rudnik275/kindle-calendar/dashboard/art/source-ref.png

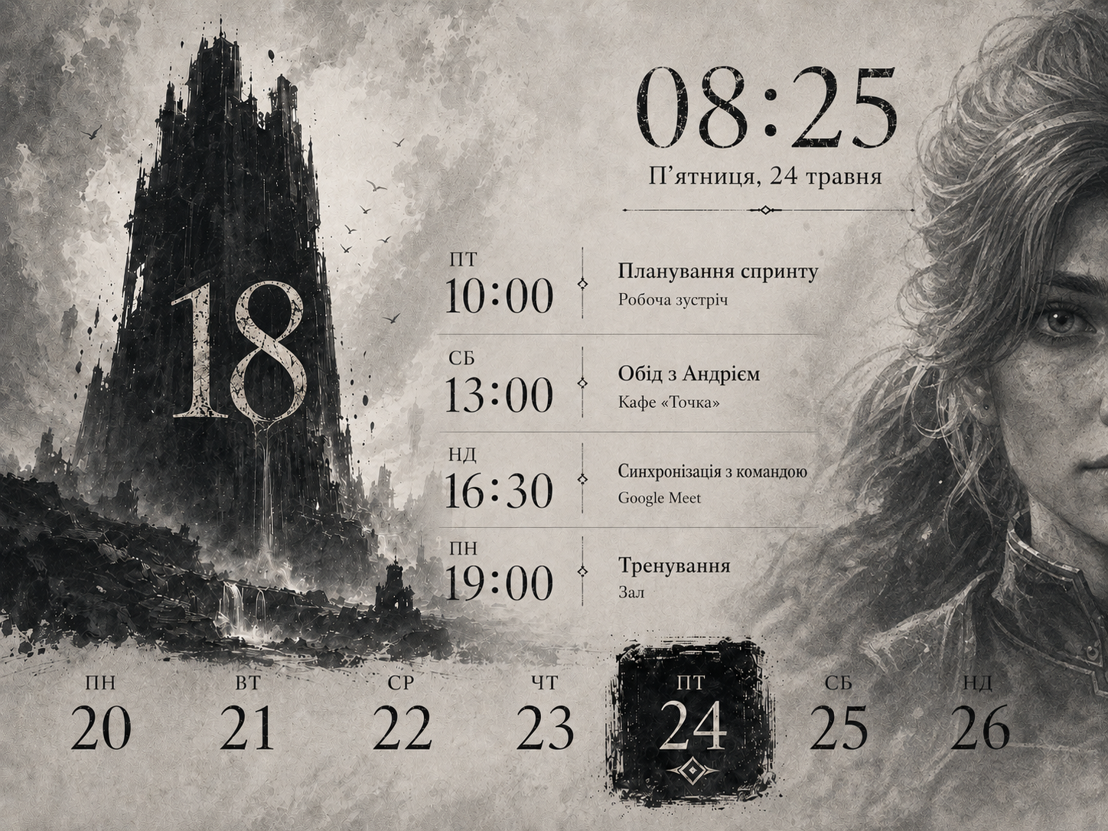
dashboard/art/source-ref.png
