rudnik275/kindle-calendar/dashboard/art/bg.png

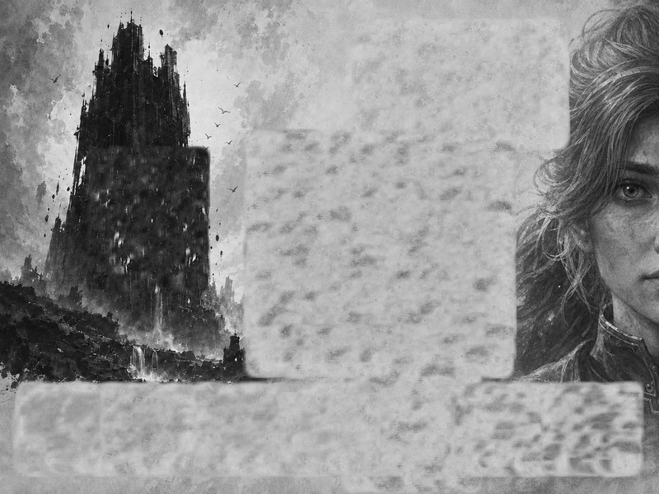
dashboard/art/bg.png
