rudnik275/kindle-calendar/dashboard/README.md

# Дашборд Kindle-календаря — dark fantasy v2 (2026-08-27)

Дизайн v2 на ассетах користувача: фон «вежа + портрет» (`art/bg2.png`),
гранжева плашка активної дати (`art/today-plate.png`), текстура зносу
шрифтів (`art/ink-mask.png`, альфа-маска — клас `.worn`, ТІЛЬКИ на великих
цифрах: дрібний текст із дірками e-ink розриває). Шрифти: Cormorant Garamond
(цифри/дисплей) + Forum (капс-лейбли) + PT Serif (текст), повна укр.
кирилиця, **локально** в `art/fonts/` — рендер не залежить від інтернету.
Екран 800×600 landscape → на панель іде портрет 600×800 (ROTATE=270 —
надрукований корпус тримає книгу «догори ногами» відносно голого
пристрою, під який калібрували до корпусу; без корпусу це було 90).

Живі дані: температура на вежі + маленька цифра «відчувається як» під нею
(Open-Meteo, координати в `live-push.sh`), годинник, дата, курс долара в
обмінниках Києва в орнамент-лінії під датою (`$ купівля · продаж`; без
даних лінія повертається до ромба), події з `local-data.js`, тижнева
стрічка з плашкою на сьогодні.

Події — 4 слоти по 72px між датою і стрічкою тижня. Рядок росте, коли
назва переноситься на 3 рядки або є локація, і 4 таких рядки лягали на
стрічку тижня (фото 2026-09-04). `fit()` у шаблоні підбирає вміст: спершу
максимум подій, потім мінімум ущільнення — повні назви → назви до 2 рядків
(хвіст «…») → без локацій → на одну подію менше. Блок ще й обрізаний по
висоті (`overflow:hidden`) як страховка. Відтворити будь-який кейс: покласти
події в `local-data.js` і `./render.sh`.

## Архітектура: живе оновлення (з 2026-08-27)

**NAS — рендерер і пушер** (`live-push.sh` у Docker-контейнері `kindle-dash`,
ставиться `nas/install-nas.sh`, деталі — `nas/README.md`). Мак робить те саме
й тим самим скриптом, але тільки як резервний шлях (`install-live.sh`,
launchd-демон `com.rudnik.kindle-dash`) — **разом їх вмикати не можна**,
битимуться за екран.

Цикл конвеєра (однаковий на обох):

- щохвилини (вирівняно на початок хвилини): рендер → push у
  `/tmp/dash-live.png` книги (tmpfs = RAM, NAND не зношується) →
  `eips -g` (частковий refresh, без блимання);
- кожні 30 хв — повний refresh (`eips -f -g`) проти ghosting;
- щогодини — копія кадру в `/mnt/us/dashboard/local/screen.png` (NAND):
  єдине, що переживає ребут книги;
- кожні 15 хв — погода Open-Meteo → `local-weather.js` (атомарно; без
  інтернету лишається останнє значення);
- 2 рази на добу — курс долара → `local-rates.js` (той самий контракт
  живучості). Основне джерело — JSON-LD зі сторінки minfin «курс у
  Києві» («середній готівковий» = середнє по обмінниках; schema.org-
  розмітка для пошуковиків, стабільніша за HTML-верстку), фолбек — API
  monobank (без ключа, курс близький до готівкового). Обидва впали →
  ретрай за 30 хв, на екрані лишається останній курс;
- кожні 15 хв — події з приватних iCal-фідів Google Calendar
  (`ical-sync.py` → `local-data.js`, теж атомарно; фіди не відповіли —
  лишаються попередні події). Тільки на NAS: на маку файлу з URL немає,
  і синк тихо пропускається;
- раз на добу — синк годинника книги (`date -u -s` + `hwclock -w`,
  RTC книги дрейфує роками);
- працює **24/7** — нічного режиму немає (рішення 2026-08-27), годинник
  тікає завжди;
- **watchdog**: 5 збоїв рендера поспіль або година без книги → вихід із
  кодом 1, щоб супервізор (`restart: always` / launchd `KeepAlive`) підняв
  процес із чистим Chrome. Це лікує клас «завис Chrome», який зсередини
  не розгребти.

### Ступор ≠ падіння (урок 2026-08-30)

Лічильники збоїв ловлять тільки те, що **впало**. Мовчазний ступор вони не
бачать: цикл стоїть на команді, яка не повертається, лічильник не росте, і
екран книги лишається з давнім кадром. Так дашборд простояв 1.5 години на
16:32 — при живому контейнері й здоровому Docker.

Причина була не в книзі й не в коді: планові скани медіатек (Plex — **кожні
~64 хв**, Jellyfin — свій) на NAS із 1.7 ГБ RAM видавлювали Chrome у своп.
Він починав вичитувати власні сторінки назад із диска, забитого тими ж
сканами: 40+ МБ/с підкачки, `load average` 18 при **простоюючому CPU**, черга
до диска ~100 операцій. Рендер ріс із секунд до 4-6.5 хвилин, а такт циклу —
одна хвилина.

Три запобіжники, кожен на своєму рівні:

- `render.sh` — `RENDER_TIMEOUT` (90 с) навколо Chrome: ступор стає звичайним
  збоєм, який лічильники вже вміють лікувати. Убитий Chrome лишає дітей —
  вони відстрілюються по власному `user-data-dir`;
- `live-push.sh` — сторож за `state/heartbeat` (`HEARTBEAT_STALL`, 7 хв):
  ловить зависання будь-де (ssh, curl, python), знімає зависле піддерево й
  шле `USR1`. Вбити PID 1 зсередини контейнера сигналом **не можна** — ядро
  не доставляє SIGKILL ініту namespace'у без обробника, звідси така схема;
- `docker-compose.yml` — `mem_swappiness: 0`: сторінки рендера не потрапляють
  у своп узагалі.

**Як розпізнати за 30 секунд:** `uptime` на NAS — високий `load average` при
`CPU` біля нуля в дужках означає, що всі стоять у черзі до диска, а не
рахують. Далі `docker ps --filter name=kindle-dash` → `unhealthy` = heartbeat
протух. Книга при цьому справна: вона штатно показує останній кадр.

⚠️ `sudo docker` на NAS відповідає `command not found` — це `secure_path`, а не
зламаний Docker. Повний шлях: `/usr/local/bin/docker`.

Рантайм навмисно **поза git** — на NAS це `/volume1/docker/kindle-dash/app`,
на маку деплой-копія `~/kindle-dash-live/`: перемикання гілок, мерджі й
чистки worktree не чіпають працюючий демон. Після зміни шаблону чи скриптів
— перезапустити відповідний інсталятор.

**Книга — тупий e-ink дисплей із фолбеком** (kindle-dash, `dash.sh`):

- цикл `*/15 * * * *` цілодобово: `fetch-dashboard.sh` бере
  `/tmp/dash-live.png`, якщо він свіжіший за NAND-копію, інакше
  `local/screen.png` — конвеєр упав/мережа зникла → екран живе далі з
  останнім кадром;
- `FULL_DISPLAY_REFRESH_RATE=96` — свій повний refresh лише раз на добу
  (основні робить мак);
- `sleeping.png` = нічний арт (сток «Kindle is sleeping» у
  `sleeping.png.bak-stock`); при 24/7-розкладі книга сама його не малює —
  чистий фолбек;
- супервізор `/var/local/sshd/start-ssh.sh` (cron `*/5`): sshd + dash по
  PID-файлах + **мережевий watchdog** — 3 страйки (~15 хв) без пінгу
  шлюзу → рестарт радіо (`wirelessEnable 0/1`), 24 страйки (~2 год) →
  ребут (все відроджується з cron; наступний ребут не раніше ніж за 6 год
  — без ребут-шторму при мертвому роутері);
- DEBUG=true (без suspend) — книга на постійному живленні, не спить;
- профілактичний тижневий ребут (cron: пн 01:45 UTC ≈ 04:45 Києва) —
  проти повільних витоків прошивки 2011 року; екран повертається сам
  за ~2 хв.

## Файли

- `template.html` — єдине джерело правди дизайну; JS на момент рендера:
  годинник, дата, події (`local-data.js`, gitignored, контракт у шапці),
  погода (`local-weather.js`, пише live-push), курс долара
  (`local-rates.js`, теж пише live-push), тиждень. Плашка сьогодні —
  `art/today-plate.png`. Великі цифри Cormorant — старостильні, з нижніми
  виносами: блоки з маскою `.worn` мусять мати padding-bottom, інакше
  маска кліпає по border-box і зрізає хвости (фікс 2026-08-27).
- `night.html` — джерело sleeping.png-фолбека (чистий арт + орнамент);
  у живому циклі НЕ використовується (нічного режиму немає).
- `render.sh` — headless Chrome/Chromium (**--allow-file-access-from-files**
  — інакше CSS-маска з file:// не рендериться) → ROTATE → grayscale.
  Кросплатформний: на маку Google Chrome + `sips`, на Linux/NAS
  `chromium` + ImageMagick (`-grayscale Rec709Luma` — голий
  `-colorspace Gray` рахує по лінійному світлу й висвітлює півтони).
- `live-push.sh` — живий конвеєр (вище), один на обидві платформи.
- `ical-sync.py` — приватні iCal-фіди → `local-data.js`. URL-и лежать у
  `secret/ical-urls` (0600, поза git) і **ніколи не друкуються в лог**.
- `nas/` — Docker-обвʼязка для Synology: `install-nas.sh`, `Dockerfile`,
  `docker-compose.yml`, `entrypoint.sh`, `healthcheck.sh` + `nas/README.md`.
- `install-live.sh` — резервний launchd-шлях на маку.
- `push-to-kindle.sh` — разова ручна заливка (діагностика).
- `calibration.html` — калібрувальна карточка e-ink.

## Ручні операції

```
ROTATE=0 ./render.sh out/preview.png        # подивитись макет (landscape)
./render.sh && ./push-to-kindle.sh          # разова заливка вручну

nas/install-nas.sh                          # ШТАТНО: перевстановити на NAS
ssh nas "sudo -n docker exec kindle-dash tail -f /app/live-push.log"

./install-live.sh                           # РЕЗЕРВ: підняти конвеєр на маку
launchctl bootout gui/$(id -u)/com.rudnik.kindle-dash   # зупинити мак-демона
```

⚠️ Одночасно на NAS і на маку конвеєр не вмикати — два пушери битимуться
за екран, e-ink блиматиме.
