rudnik275/kindle-calendar/KindleDeskCalendar/README_RU.md

# Асимметричный корпус-календарь для Kindle 4 — v0.2

Настольный e-ink календарь: Kindle 4 (D01100) горизонтально, виден только экран,
загрузка сзади, сверху козырёк с тёплой подсветкой. Референс — сгенерированный
рендер «скульптуры» (см. чат от 2026-08-24/25).

## Файлы

- `KindleDeskCalendar.py` — генератор модели Fusion 360 (v0.2). Единственный
  источник правды — блок `CONFIG` в начале. Правишь CONFIG → перезапускаешь.
- `KindleDeskCalendar_v0.1.py.bak` — исходная версия от ChatGPT (архив).
- `KindleDeskCalendar.manifest` — манифест для Scripts and Add-Ins.
- `stl/` — **только v0.1, болванки для оценки масштаба. Не печатать.**
- `profiles/front_profiles.dxf` — контуры фасада v0.1.

## Что изменилось в v0.2 (после ревью)

1. **USB-бухта сбоку, не снизу.** В ландшафте разъёмная грань Kindle 4
   вертикальна. Добавлен карман под угловой micro-USB штекер + канал кабеля
   вниз + вырез в задней крышке. Сторона (`usb_side`) и позиция
   (`usb_center_y`) — уточнить по реальному девайсу.
2. **Прижим по глубине.** 4 бобышки на задней крышке добирают зазор 2.85 мм —
   Kindle больше не болтается.
3. **Крепёж.** 4 винта M2.5: сквозные отверстия d2.8 в крышке + пилоты d2.2 в
   корпусе. Козырёк — 2 штифта d4 в отверстия d4.4 на фасаде (+ клей).
4. **Устойчивость.** Отдельная базовая плита 210×80×8 с двумя рельсами
   (паз 15.4 мм). Низ силуэта сплющен (130 мм по y=−72) и садится в паз.
   Плита моделируется лёжа (ориентация печати), в сборке не спозиционирована.
5. **Ровные прямоугольники.** Все прямоугольные контуры — линии + дуги
   (в v0.1 были fitted-сплайны: волнистые кромки, недокрученные углы).
6. **Убраны фиктивные userParameters** — они не двигали геометрию и вводили
   в заблуждение.

## Перед печатью — измерить штангенциркулем

`kindle_width/height/depth`, `screen_width/height`, `screen_center_x/y`,
`screen_corner_radius`, `usb_side`, `usb_center_y`. Первая печать — плоская
маска окна 0.8–1 мм и купон посадки кармана, только потом корпус.

## Печать (PETG, Bambu A1 у друга)

- Фасад: лицом вниз на текстурной пластине, 0.16–0.20 мм, 4 периметра.
- Крышка, плита: как лежат в модели. Плита уже смоделирована печатной стороной.
- Диффузор: молочный/натуральный PETG, 1–2 периметра, 100% прозрачного эффекта
  не ждать — это и есть рассеивание.
- Козырёк: отдельно, штифтами вниз обычно не выйдет — печатать плоскостью
  примыкания вниз, штифты вверх (или отверстия под отдельные штифты-палочки).

## Подсветка и питание (решение от 2026-08-25, ревизия: без Aqara T1)

- Свет: **ESP32 + HAA** (стек лампы-космонавта) + MOSFET logic-level
  (AO3400/IRLZ44N, затвор 100R + pulldown 10k) + **COB-лента 5V** тёплая
  2700–3000K, отрезок ~30 см в козырьке за диффузором, 30–40° вниз,
  яркость 20–30%. Нативный HomeKit white dimmer, ~350–650 грн итого.
- **Кнопка на GPIO** (тактовая или TTP223) — HAA поддерживает из коробки:
  и физическая клавиша, и Home.app/Siri. Автоматизации по расписанию —
  после покупки Apple TV (нужен домашний хаб Apple).
- Питание: **одно гнездо USB-C наружу** (breakout ОБЯЗАТЕЛЬНО с CC-резисторами
  5.1k — иначе кабель C→C не заведётся), любая зарядка 5V/2A. Внутри общая
  5V-шина: micro-USB хвост в Kindle (**D+ и D− закоротить** — сигнал DCP),
  ESP32 на VIN, лента через MOSFET. Бюджет тока: ≤0.5A Kindle + ~0.3A лента
  + ~0.2A ESP32 < 1.5A. LED к плате/батарее Kindle НЕ подключать.
- v0.3 корпуса: гнездо USB-C и отсек электроники — в базовой плите (карман
  ~60×40×6 с крышкой снизу), кнопка — верхний торец или декор-отверстие.
- Софт: NAS рендерит PNG 600×800 (MagicMirror² → headless Chrome), Kindle с
  jailbreak + kindle-dash тянет картинку по Wi-Fi.

## Известные ограничения v0.2

- Плита не спозиционирована в сборке (моделируется лёжа для печати).
- Козырёк держится на 2 штифтах + клей; при желании добавить винт M2.5 сверху.
- Форма — 2.5D экструзия силуэта, не полная «скульптура» из референса;
  скругления/лофт фасада — кандидат на v0.3 после первой примерки.
