rudnik275/kindle-calendar/dashboard/nas/README.md

# Рендер-конвеєр на NAS (Synology DSM 7)

Штатне місце життя конвеєра. Мак більше не точка відмови: він може спати,
перезавантажуватись і їхати у відпустку — годинник на книзі тікає далі.

```
Google Calendar (приватні iCal) ─┐
Open-Meteo (погода) ─────────────┤
                                 ▼
   NAS · Docker «kindle-dash» · щохвилини
   ical-sync.py → local-data.js ┐
   curl → local-weather.js      ├→ chromium 800×600 → ImageMagick → PNG 600×800
                                ┘                              │
                                                               ▼
                              ssh root@kindle: cat > /tmp/dash-live.png; eips -g
```

## Розгортання й оновлення

З мака, з каталогу репозиторію:

```
dashboard/nas/install-nas.sh              # деплой + збірка образу + старт
dashboard/nas/install-nas.sh --no-build   # тільки оновити бандл і рестарт
```

Скрипт ідемпотентний — ганяй після кожної правки `template.html`, `render.sh`
чи `live-push.sh`. Він не чіпає рантайм-стан: `app/state`, `app/secret`,
`app/ssh`, `app/local-data.js`, `app/local-weather.js`.

Образ збирається **на самому NAS**: мак — arm64, NAS — x86_64.

## Розкладка на NAS

```
/volume1/docker/kindle-dash/
├── docker-compose.yml   Dockerfile   entrypoint.sh   healthcheck.sh
└── app/                     ← бінд-маунт у контейнер як /app
    ├── template.html night.html render.sh live-push.sh ical-sync.py art/
    ├── local-data.js        ← генерує ical-sync.py (у git не йде)
    ├── local-weather.js     ← генерує live-push.sh (у git не йде)
    ├── live-push.log
    ├── ssh/                 ← ключ NAS→книга (0600) + known_hosts
    ├── secret/ical-urls     ← приватні iCal-URL, 0600 (у git не йде)
    └── state/               ← мітки часу, heartbeat, лок
```

Увесь стан — на `/volume1`, тому перестворення контейнера чи ребут NAS
нічого не втрачають.

## Календар: увімкнути живі події

Поки файлу `secret/ical-urls` немає, на екрані висить снапшот подій, залитий
при першому деплої. Щоб події оновлювались самі, треба покласти приватні
iCal-URL Google Calendar.

Де взяти: Google Calendar → налаштування потрібного календаря → «Інтеграція
календаря» → **Приватна адреса в форматі iCal**.

> ⚠️ Такий URL = пароль на читання календаря. Канонічне місце зберігання —
> 1Password; на NAS він лежить у файлі 0600 і ніде більше. У логи він не
> потрапляє: `ical-sync.py` друкує лише порядковий номер фіда, не адресу.
> Не вставляй ці URL у чат і не коміть у репозиторій — він публічний.

**Як додати (по разу на кожен календар):** натисни в Google Calendar око 👁
біля «Закритої адреси», потім кнопку копіювання — і одразу:

```
dashboard/nas/add-ical-url.sh          # бере URL із буфера обміну
dashboard/nas/add-ical-url.sh --ask    # або прихований ввід, якщо буфер не годиться
```

Скрипт перевіряє формат, кладе URL у файл 0600 на NAS, відсіює дублікати
(порівняння робиться на боці NAS) і одразу ганяє синк, показуючи лише
**кількість** подій. Саме значення не друкується ніде.

ℹ️ Емодзі з назв подій (`🎂 День народження`) `ical-sync.py` вирізає: локальні
шрифти їх не мають, і на екрані замість емодзі був порожній квадрат-tofu перед
текстом. Тягнути емодзі-шрифт заради монохромного e-ink сенсу немає — вони б
однаково виглядали чужорідно. Тире, градуси й решту типографіки не чіпаємо.

⚠️ **Розкрити «Закриту адресу» може тільки людина.** Google тримає поле
замаскованим (`••••••••••`) і не піддається ні JS-кліку, ні довіреному
CDP-кліку, ні натисканню кнопки копіювання з автоматизації — перевірено.
Це навмисний захист Google, обходити його не треба: два кліки руками і
`add-ical-url.sh` роблять усе решта.

### ⛔ Робочий календар Novaposhta — РІШЕННЯ: НЕ РОБИМО (Дмитро, 2026-08-27)

**Питання закрите, розкопувати заново не треба.** Дашборд показує лише
особистий календар; те, що Дмитро сам додає до нього, зʼявляється на екрані
автоматично. Просити IT про схвалення він не буде, обхідні шляхи —
відхилено. Нижче — чому, щоб не проходити цей шлях удруге.

Окремо перевірено й відкинуто ідею «просто затягнути робочі події в основний
календар»: єдиний автоматичний спосіб — скрипт під робочим акаунтом, тобто
той самий обхід. Дозволений шаринг «вільний/зайнятий» теж не рятує — робочий
календар зайшов би в особистий акаунт **окремим** календарем, а приватна
iCal-адреса видається на кожен календар окремо й належить власнику, тож на
дашборд ці блоки все одно не потрапляють.

#### Що саме заблоковано (три незалежні контролі)

Перевірено 2026-08-27 у живому акаунті:

- у розділі «Інтеграція календаря» пункту **«Закрита адреса у форматі iCal»
  немає взагалі** — після загальнодоступної адреси одразу «Видалити календар»;
- у діалозі «Доступ для окремих користувачів» зовнішній адресі
  (`dmitriyrudnik@gmail.com`) варіант **«переглядати всі деталі подій»
  вимкнений** (`disabled`), доступний лише «вільний/зайнятий».

Тобто адмін Workspace novaposhta.ua заборонив віддавати календар **назовні**:
ні анонімному iCal-URL, ні іншій пошті деталі подій не дістаються.

⚠️ **Але це стосується лише зовнішнього доступу — не доступу самого власника.**
Коли Дмитро дивиться календар на планшеті, він залогінений як
`rudnyk.dm@novadigital.com` і бачить усе: ACL тут ні до чого, він власник.
Дашборд не бачить подій не тому, що заборонено, а тому, що він **ні під ким
не залогінений** — тягне анонімний URL.

Отже робочий шлях: конвеєр має ходити в Google **як робочий акаунт**, тобто
бути звичайним календарним клієнтом (як застосунок на планшеті):

- **Google Calendar API з OAuth під робочим акаунтом** — ⛔ теж заблоковано.
  Проєкт `kindle-dash-506809` створено, Calendar API увімкнено, OAuth-клієнт
  (Desktop) готовий, `gcal-authorize.py` написано — але на кроці згоди Google
  віддає **`access_not_configured`**: «You can't access this app until an admin
  at your institution reviews and configures access for it». У НП увімкнено
  **App Access Control**: сторонні OAuth-застосунки має схвалити адмін.
  Запит на схвалення (посилання дав сам Google):
  `https://admin.google.com/ac/owl/requestapp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`
  Після схвалення все готове: `gcal-authorize.py` → токен → NAS.
- **Google Apps Script** — доступний (перевірено: не заблокований, тригери є),
  бо виконується як код самого користувача в межах домену.

⚠️ **Але варто бачити картину цілком.** НП закрила цей напрямок **тричі
незалежно**: немає приватної iCal-адреси, зовнішній шаринг обрізано до
«вільний/зайнятий», сторонні OAuth-застосунки — тільки з дозволу адміна.
Це не випадковість, а свідома позиція: календарні дані не мають залишати
кероване середовище. Apps Script технічно винесе ті самі дані повз ці
контролі — рішення про це має ухвалювати Дмитро як співробітник, який знає
внутрішні правила, а не автоматика.

Чистий шлях — попросити IT НП: або схвалити застосунок за посиланням вище,
або увімкнути зовнішній доступ (Admin console → Apps → Google Workspace →
Calendar → Sharing settings) — тоді «Закрита адреса» зʼявиться сама й
`add-ical-url.sh` усе доробить.

## Живучість при перезавантаженні NAS

П'ять незалежних шарів — жоден не вимагає ручних дій після ребуту:

| Шар | Що дає |
|---|---|
| `restart: always` | демон Docker піднімає контейнер, щойно стартує сам |
| Container Manager стартує з DSM | демон Docker узагалі зʼявляється після ребуту |
| стан на `/volume1` (бінд-маунт) | події, погода, лог, мітки часу переживають усе |
| все зашите в образ | на старті не потрібні ні інтернет, ні реєстр: NAS вантажиться швидше за роутер |
| watchdog у `live-push.sh` | серія збоїв рендера (5) або година без книги → `exit 1` → Docker піднімає з чистим Chrome |

Плюс `healthcheck.sh`: у `docker ps` видно `healthy`/`unhealthy` за свіжістю
`state/heartbeat` (поріг 5 хв). Це індикатор, лікування робить watchdog.

Книга з іншого боку теж самостійна: cron-супервізор, мережевий watchdog,
щотижневий профілактичний ребут, фолбек на NAND-копію кадру. Якщо конвеєр
мовчить, екран не гасне — просто завмирає на останньому кадрі.

### Перевірка після змін

```
ssh nas "sudo -n docker kill kindle-dash"     # має піднятися сам за секунди
ssh nas "sudo -n docker ps --filter name=kindle-dash"
```

## Щоденне

```
# лог конвеєра
ssh nas "sudo -n docker exec kindle-dash tail -f /app/live-push.log"

# стан і здоровʼя
ssh nas "sudo -n docker ps --filter name=kindle-dash --format '{{.Status}}'"

# памʼять (NAS має 10 ГБ від 2026-09-03; лімітів у контейнера немає)
ssh nas "sudo -n docker stats --no-stream kindle-dash"

# разовий рендер без пуша (подивитись, що вийшло)
ssh nas "sudo -n docker exec kindle-dash bash -c 'QUIET= /app/render.sh /tmp/t.png'"
```

## Мак як резервний шлях

Старий launchd-конвеєр нікуди не подівся — `dashboard/install-live.sh`.
Обидва одночасно вмикати НЕ можна: вони битимуться за екран, e-ink
блиматиме. Перемикання:

```
launchctl bootout gui/$(id -u)/com.rudnik.kindle-dash        # вимкнути мак
ssh nas "cd /volume1/docker/kindle-dash && sudo -n docker compose stop"   # вимкнути NAS
```
