rudnik275/kindle-calendar/dashboard/art/bg2.png

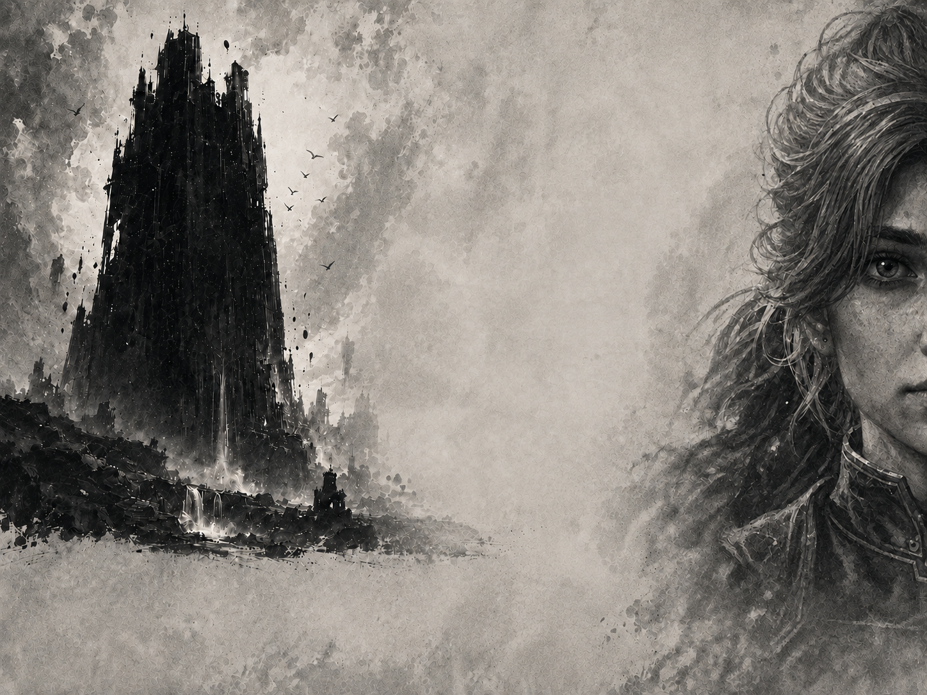
dashboard/art/bg2.png
