rudnik275/kindle-calendar/dashboard/art/today-plate.png

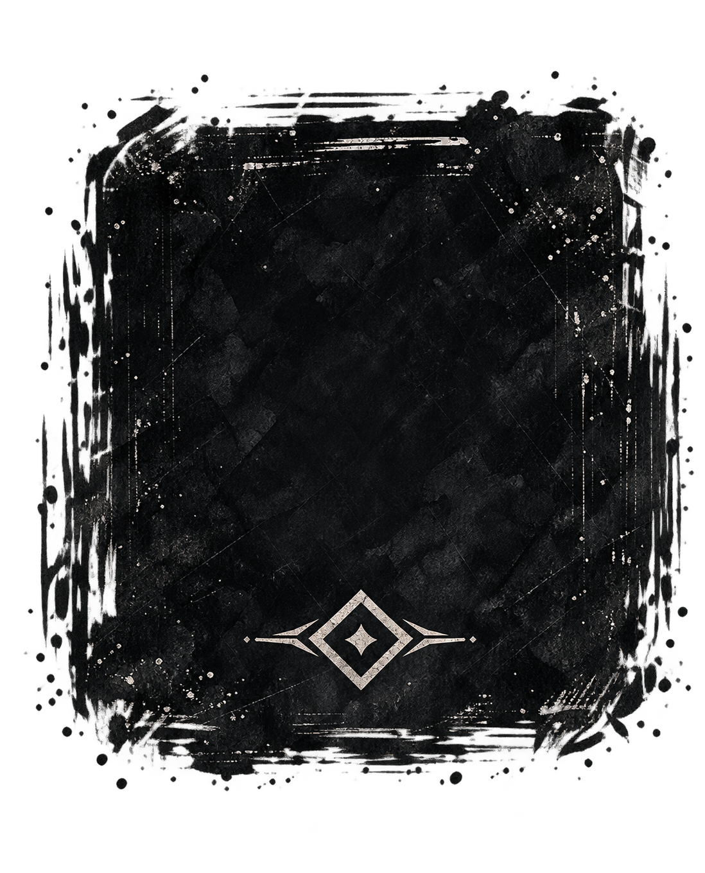
dashboard/art/today-plate.png
