rudnik275/kindle-calendar/render_front.png

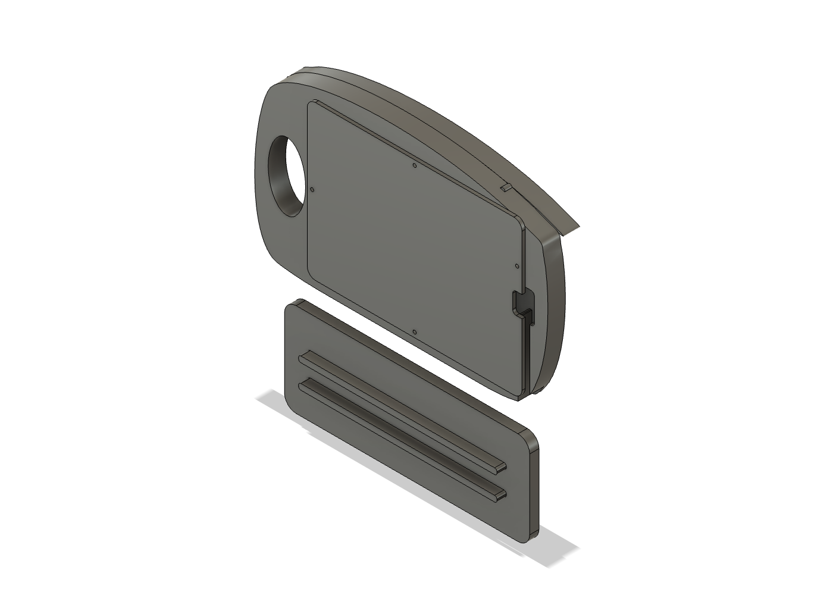
render_front.png
