rudnik275/kindle-calendar/render_front_flat.png

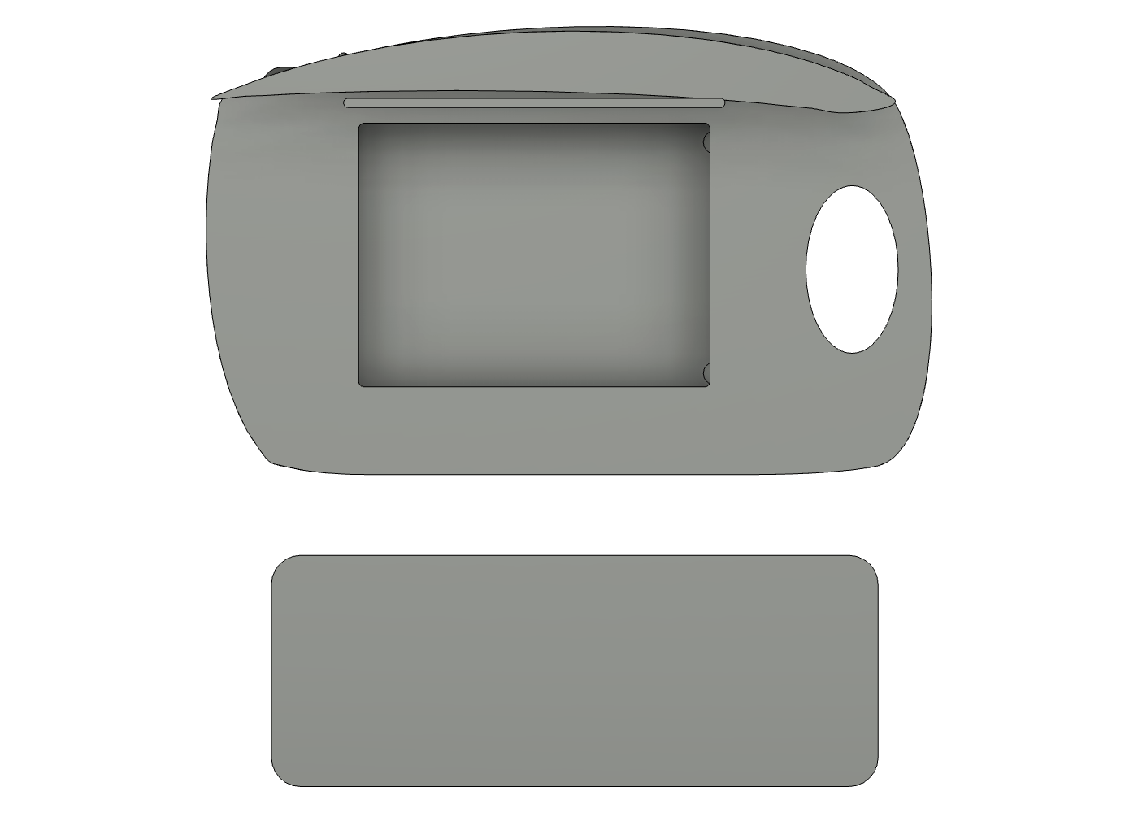
render_front_flat.png
