rudnik275/kindle-calendar/render_front_iso.png

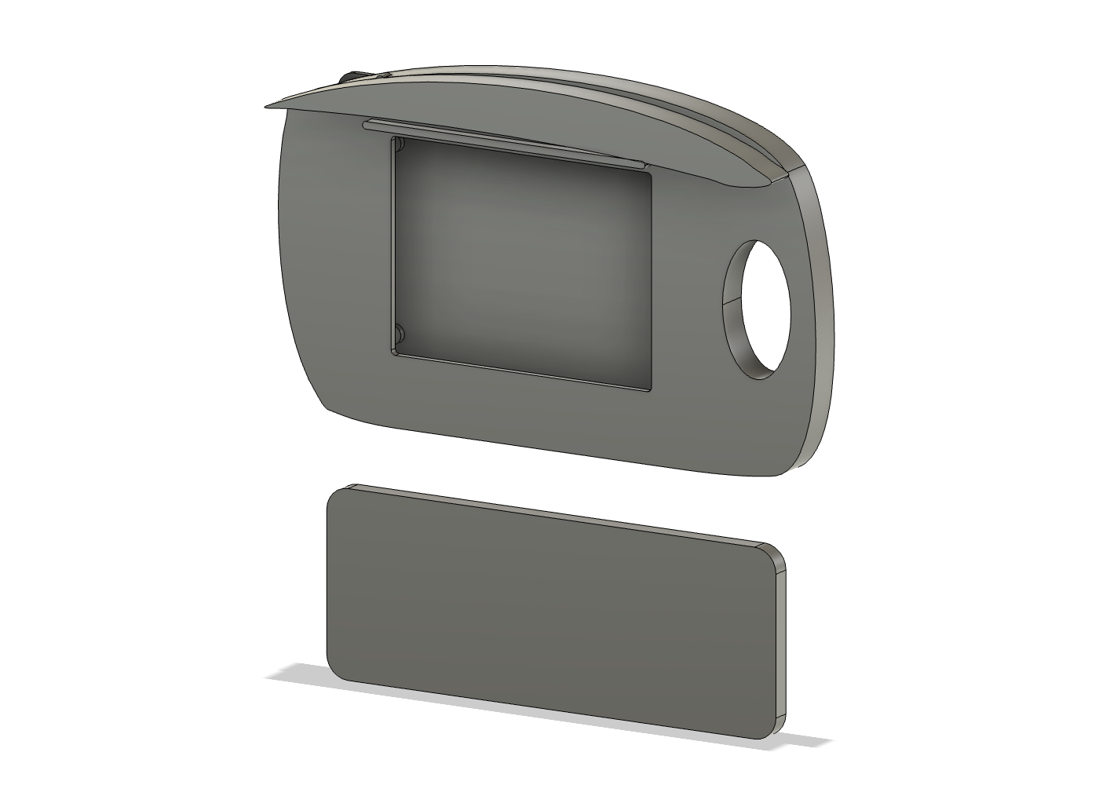
render_front_iso.png
