rudnik275/kindle-calendar/KindleDeskCalendar/stl/02_kindle_cradle.stl

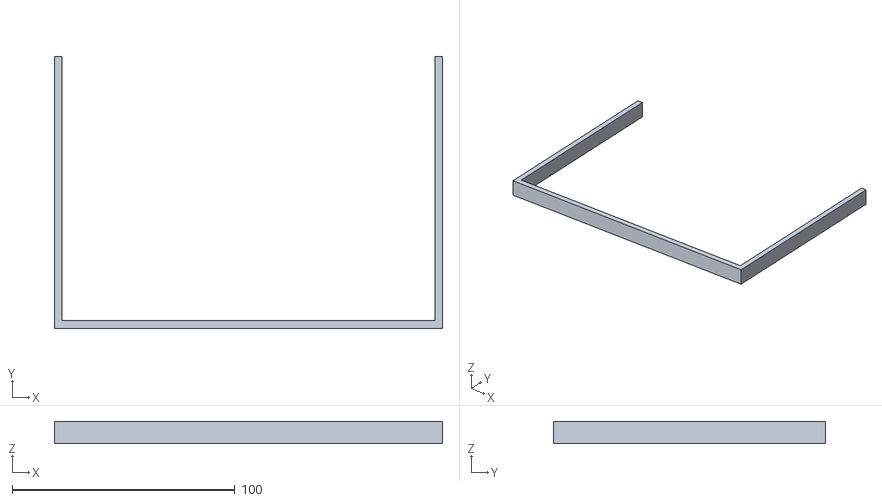
[picture p8: CAD file, 2026-08-25]
KindleDeskCalendar/stl/02_kindle_cradle.stl
174.0 x 122.0 x 10.0
