rudnik275/kindle-calendar/KindleDeskCalendar/stl/01_front_sculpture.stl

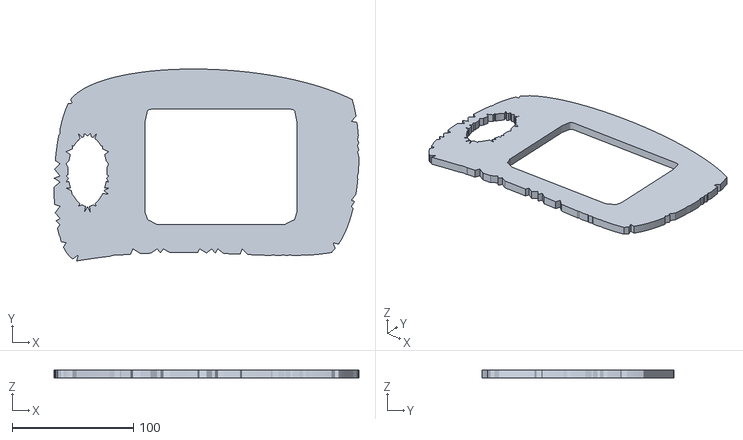
[picture p9: CAD file, 2026-08-25]
KindleDeskCalendar/stl/01_front_sculpture.stl
251.2 x 158.1 x 7.00
