rudnik275/kindle-calendar/KindleDeskCalendar/stl/03_rear_cover.stl

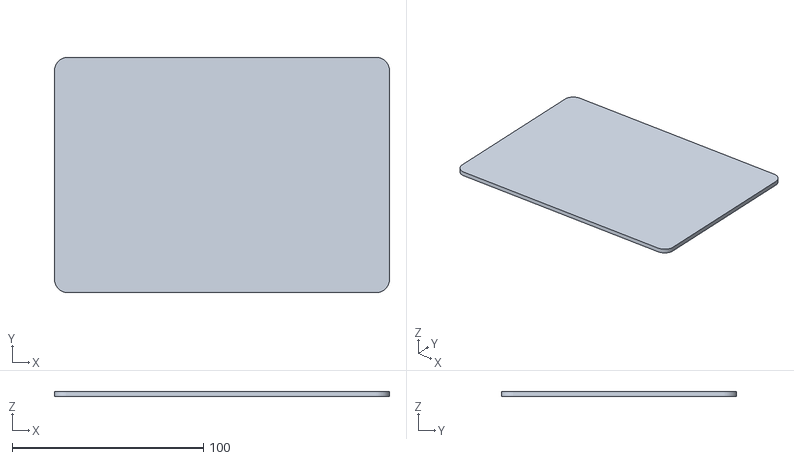
[picture p10: CAD file, 2026-08-25]
KindleDeskCalendar/stl/03_rear_cover.stl
175.0 x 123.0 x 2.80
