rudnik275/kindle-calendar/KindleDeskCalendar/stl/04_light_hood.stl

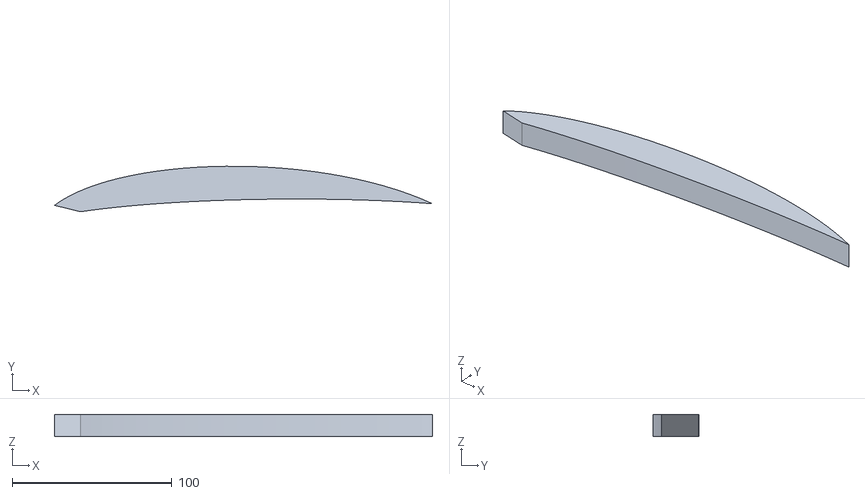
[picture p11: CAD file, 2026-08-25]
KindleDeskCalendar/stl/04_light_hood.stl
237.0 x 28.5 x 14.0
