rudnik275/kindle-calendar/KindleDeskCalendar/stl/05_opal_diffuser.stl

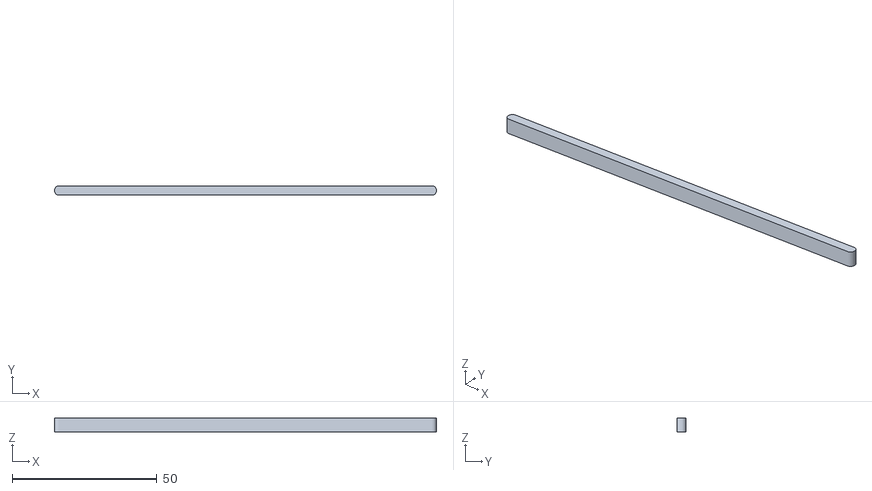
[picture p12: CAD file, 2026-08-25]
KindleDeskCalendar/stl/05_opal_diffuser.stl
132.0 x 3.20 x 5.00
