rudnik275/kindle-calendar/(list of files, cad)

Other CAD files:
KindleDeskCalendar/profiles/front_profiles.dxf
kindle-calendar-v0.2.f3d
