rudnik275/kindle-calendar/dashboard/calibration.html

# Калібрування e-ink · оціни НА ПАНЕЛІ і назви номери

## Лінії (тонкість/сірість)

1

2

3

4

5

6

7

8

## Рамки-картки

11

12

13

14

15

16

## Заливки сірим

21 22 23 24 25 26 27 28

## Спарклайни (обводка)

31

32

33

34

35

## Текст Onest (AA як є)

41 · Стендап команди 10:00

42 · Найближчі дні, вівторок

43 · slotranker · кліки · 7 дн

## Текст без згладжування

44 · Стендап команди 10:00

45 · Найближчі дні, вівторок

46 · slotranker · кліки · 7 дн

## Інверсія (today у сітці)

5126 5226 5326
