rudnik275/kindle-calendar/(commit log)

2026-08-25 kindle-calendar: корпус v0.2 (Fusion-генератор) + рендеры
    - KindleDeskCalendar.py v0.2: USB-бухта сбоку, прижимные бобышки, винты M2.5,
    штифты козырька, базовая плита с рельсами, line+arc прямоугольники
    - README: схема подсветки ESP32+HAA+кнопка, питание через USB-C (CC 5.1k),
    закупочный список
    - рендеры фасада и тыла из Fusion
    Claude-Session: https://claude.ai/code/session_012VBoh9zsnwgbxe8j8G5AP3
    [01_front_sculpture.stl, 02_kindle_cradle.stl, 03_rear_cover.stl, 04_light_hood.stl, 05_opal_diffuser.stl, front_profiles.dxf]
2026-08-25 add f3d backup of v0.2 (also saved to Fusion cloud as kindle-calendar-v0.2)
    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
    [kindle-calendar-v0.2.f3d]
2026-08-26 dashboard: финальный дизайн экрана (веб-интерфейс) + конвейер рендера
    Выбран вариант «веб-интерфейс» (product-UI) из четырёх направлений
    (передовица / швейцарский плакат / терминал / веб). Onest + JetBrains Mono,
    карточки, линия текущего времени, GSC stat-плитки со спарклайнами.
    - template.html — источник правды дизайна; дата/«оновлено»/линия
    времени/мини-месяц считаются JS при рендере, события/погода/GSC — мок
    до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
2026-08-26 dashboard: e-ink токени за калібруванням на панелі
    Калібрувальна картка (calibration.html) на живій панелі показала: сірі
    hairline'и e-ink рве, AA-скруглення бруднить кути. За вибором номерів:
    - рамки карток: 1px #000, прямі кути (було #c2c2c2 r12)
    - світло-сірі роздільники прибрані (ритм відступами), між днями 1px #000
    - лінія поточного часу 2px, today-квадрат без радіуса
    - спарклайни/заливки/текст — без змін (панель схвалила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
2026-08-26 dashboard: реальний календар через local-data.js, мінус GSC і «оновлено»
    - події рендеряться з local-data.js (window.DASH_DATA, gitignored);
    зараз знапшот Google Calendar (особистий+Семья+English+свята, вікно
    today+5), автогенерація — фаза NAS
    - лінія поточного часу стає в хронологію подій дня; порожній день —
    «подій немає» / «вільний день»
    - GSC-плитки прибрані (за бажанням повернемо з git-історії)
    - мітка «оновлено HH:MM» прибрана
    - м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
2026-08-26 dashboard: редизайн за користувацьким референсом (укр)
    Погода-картка (Київ: зараз/відчувається/вітер/вологість/тиск/видимість +
    погодинна смужка, поки мок) · таймлайн ПОДІЇ з крапками за близькістю і
    зворотним відліком («за 5 днів») · тижнева смужка пн–нд з рамкою сьогодні ·
    футер: слогани + годинник. Line-іконки SVG 1.6px. Події — реальні з
    local-data.js (два дні народження), решта контракту без змін.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
2026-08-26 dashboard: dark-fantasy редизайн за референсом (пергамент + антиква)
    Cormorant Garamond (годинник/великі цифри, old-style figures) + PT Serif
    (текст) — обидва з повною укр. кирилицею. Пергамент: feTurbulence-зерно
    (працює і як дизеринг на e-ink) + віньєтка. Ромби-орнаменти, чорнильний
    квадрат сьогодення з рваними краями (feDisplacementMap). Події з
    local-data.js: all-day показують «31 СЕР» замість часу. Гігантське число
    зліва = поточна температу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
2026-08-26 dashboard: точне відтворення dark-fantasy референсу
    Фон — сам референс зі стертим запеченим текстом: art/clean-bg.py
    (texture-bomb клонування з фліпами, двоетапний bootstrap — очищена зона
    годинника стає джерелом пергаменту, tone-match зон). Текст накладається
    HTML у координати оригіналу (масштаб 800/1448), Cormorant Garamond +
    PT Serif, multiply-блендинг вбирає текстуру. Температура на вежі з
    чорнильною плямою-підкладкою. Події реаль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
2026-08-26 dashboard v2: арт-ассети користувача + живий конвеєр мак→Kindle
    Дизайн: фон «вежа+портрет», гранжева плашка активної дати, текстура
    зносу як альфа-маска на великих цифрах (--allow-file-access-from-files
    обов'язковий, інакше headless Chrome мовчки ховає замасковане), шрифти
    локально (Cormorant Garamond + Forum + PT Serif), температура по центру
    вежі + «відчувається як», нічний екран night.html.
    Живе оновлення: live-push.sh (launchd, деплой-копі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
2026-08-27 dashboard: прибрати нічний режим — годинник 24/7
    Рішення Діми: нічне вікно не потрібне. live-push пушить живий кадр
    цілодобово; night.html лишився лише джерелом sleeping.png-фолбека,
    який книга з 24/7-розкладом сама ніколи не малює.
    Claude-Session: https://claude.ai/code/session_019oLabTDLB2ZjarE7xoLBE3
2026-08-27 Рендер переїхав на NAS: Docker-конвеєр, що переживає ребут (#2)
    * рендер переїхав на NAS: Docker-конвеєр, що переживає ребут
    Мак більше не точка відмови — конвеєр крутиться в контейнері kindle-dash
    на Synology (restart: always), мак лишається задокументованим резервом.
    Живучість при ребуті NAS — п'ять незалежних шарів:
    - restart: always + Container Manager стартує з DSM (перевірено:
    контрольний контейнер, що падає сам, підніма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
2026-08-27 dashboard: курс долара в обмінниках + фікс зрізаних цифр + центрування температури (#4)
    - Курс долара (обмінники Києва) в орнамент-лінії під датою: live-push
    тягне 2р/добу JSON-LD зі сторінки minfin «курс у Києві» (середній
    готівковий), фолбек — API monobank; local-rates.js за контрактом
    живучості погоди (атомарно, при збої лишається останнє значення,
    ретрай за 30 хв). Без даних лінія повертається до ромба.
    - Маск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
2026-08-28 dashboard: прибрати рядок «сьогодні подій немає» (#5)
    Порожній день тепер лишається порожнім. На e-ink пустота під датою
    читається як «вільно» краще за курсивний напис, а сам рядок ще й з'їдав
    один із чотирьох слотів списку: у день без подій показувалось три
    майбутні замість чотирьох.
    Разом із заглушкою пішов і мертвий після неї код — параметр muted у
    row(), правило .evr.muted та обчислення todayStr.
    Claude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
2026-08-30 dashboard: назви подій не жирним (#7)
    PT Serif у art/fonts має тільки 400 і 700 — проміжного накреслення нема,
    тому «менш жирно» означає рівно 400 (font-weight:600 CSS-матчинг усе одно
    підтягнув би Bold). Кегль 16→17px, щоб назва лишалась помітнішою за .sub
    після втрати ваги; ієрархію тепер тримають розмір і колір.
    Claude-Session: https://claude.ai/code/session_01FM77Q4MPhsyCZyTz8RKqLP
2026-08-30 dashboard: лікуємо ступор рендера, а не лише його падіння (#8)
    Екран книги простояв 1.5 години на 16:32 при живому контейнері й здоровому
    Docker. Книга справна — вона штатно показувала останній кадр; став конвеєр.
    Причина не в коді дашборда: планові скани медіатек (Plex — кожні ~64 хв,
    Jellyfin — свій) на NAS із 1.7 ГБ RAM видавлювали Chrome у своп. Той починав
    вичитувати власні сторінки назад із диска, забитого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
2026-09-03 nas: зняти ліміти памʼяті kindle-dash після апгрейду RAM до 10 ГБ (#11)
    У DS720+ додано 8 ГБ Samsung (M471A1K43CB1-CTD) у вільний слот SODIMM — разом
    із 2 ГБ розпаяних NAS бачить 10 ГБ. Ліміти mem_limit/memswap_limit 640m стояли
    через 1.7 ГБ на всіх сусідів; тепер вони лише заважають. Історію рішення
    (підкачка Chrome 2026-08-30, чому не mem_swappiness) залишено в коментарі.
    Claude-Session: https://claude.ai/code/session_01KMngCK4LKGxq7AczKb2MkM
2026-09-04 dashboard: події більше не лягають на стрічку тижня (#12)
    Блок подій не мав обмеження по висоті: рядок із min-height 72px росте,
    коли назва переноситься на 3 рядки або є локація, і 4 таких рядки
    виїжджали на плашку сьогоднішньої дати й підписи днів (фото 2026-09-04
    20:31 — «Суд по инвалидности» поверх ЧТ/ПТ).
    Тепер .events має рівно 4 слоти по висоті (291px, overflow:hidden як
    страховка), а fit() у скрипті підбирає вміст: спе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
2026-09-22 dashboard: перевернути кадр на 180° під надрукований корпус (#13)
    Корпус надруковано, і він тримає книгу протилежним боком догори відносно
    голого пристрою на столі, під який калібрували орієнтацію спершу. Кадр на
    панелі виходив догори ногами.
    ROTATE у render.sh ніде не перевизначається: live-push.sh викликає рендер
    лише з QUIET і TEMPLATE, docker-compose змінної не має. Тобто дефолт у
    самому скрипті — це і є орієнта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
2026-10-19 backlight: прошивка Nano для підсвітки козирка (#15)
    Енкодер на D2/D3 крутить яскравість по гамма-кривій, клік на D4 — вкл/викл
    плавно з памʼяттю рівня. ШИМ на D9 — Timer1, 10 біт, 15,6 кГц, інверсний під
    P-канальний AO3401; вимкнено — ШИМ відʼєднано, D9 тримається HIGH. Рівень і
    стан пишуться в EEPROM через 5 с після останньої зміни. Serial 115200 друкує
    рівень для перевірки на стенді.
